codmpm/esp-mqtt-doorbell-receiver/esp-mqtt-doorbell-receiver.sch

## EAGLE design esp-mqtt-doorbell-receiver.sch (2017-04-06)

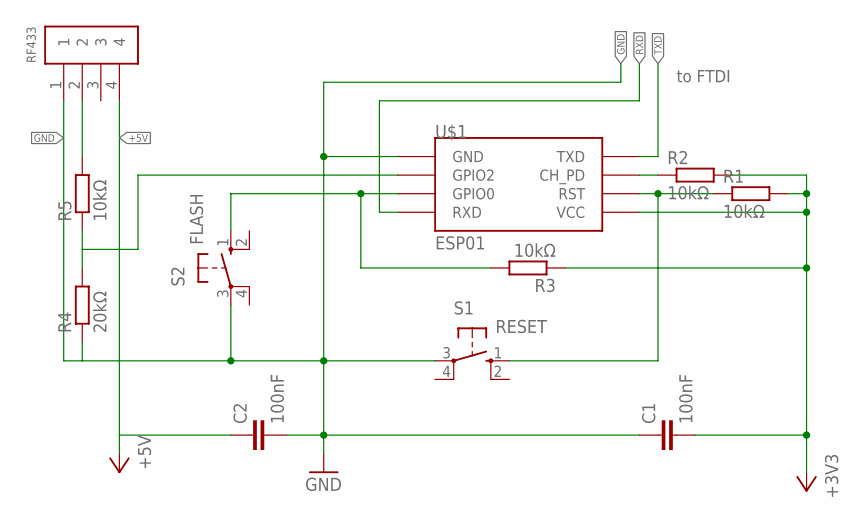
[picture p4: schematic esp-mqtt-doorbell-receiver.sch]

Parts:
C1, C2: 100nF; C025-025X050
R1, R2, R3, R5: 10kΩ; 0204/7
R4: 20kΩ; 0204/7
RF433: 1X4-BIG; 1X04-BIG
S1: RESET; B3F-10XX
S2: FLASH; B3F-10XX
U$1: ESP01

Connections:
+3V3: C1.2, R1.2, R2.2, R3.1, U$1.VCC
+5V: C2.1, RF433.4
GND: C1.1, C2.2, R4.1, RF433.1, S1.3, S2.3, U$1.GND
unnamed: R1.1, S1.1 (S), U$1.RST
unnamed: R3.2, S2.1 (S), U$1.GPIO0
unnamed: R2.1, U$1.CH_PD
unnamed: R5.2, RF433.2
unnamed: R4.2, R5.1, U$1.GPIO2
RXD: U$1.RX (RXD)
TXD: U$1.TX (TXD)

Notes on the sheet:
to FTDI
