codmpm/esp-mqtt-doorbell-receiver/(commit log)

2017-04-06 added circuit schematics and eagle file
    [esp-mqtt-doorbell-receiver.sch]
2017-04-17 added image of self built board
